thesunRider/hololit/docs/back_layer.PNG

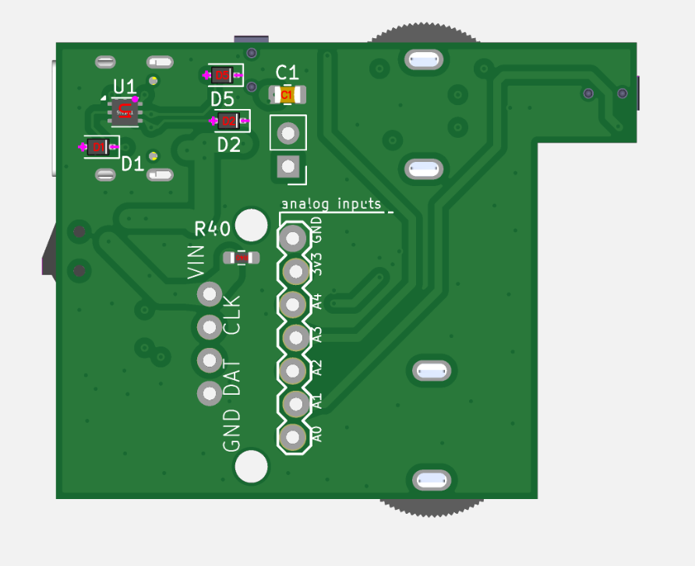
docs/back_layer.PNG
