thesunRider/hololit/docs/capture-2025-04-30T06_42_58.021Z.png

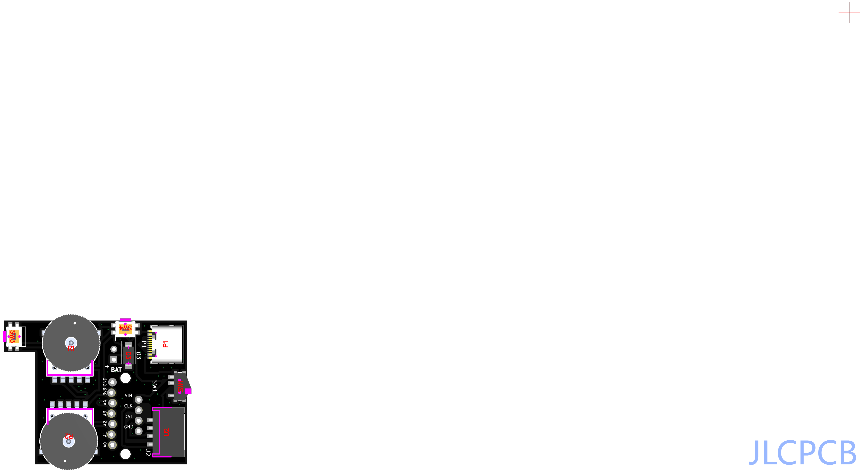
docs/capture-2025-04-30T06_42_58.021Z.png
