thesunRider/hololit/docs/capture-2025-04-30T06_43_24.876Z.png

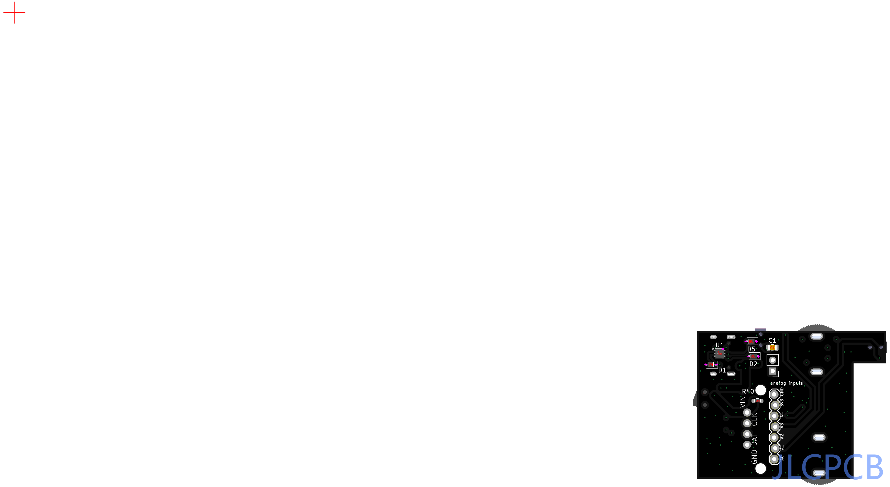
docs/capture-2025-04-30T06_43_24.876Z.png
