thesunRider/hololit/docs/front_layer.PNG

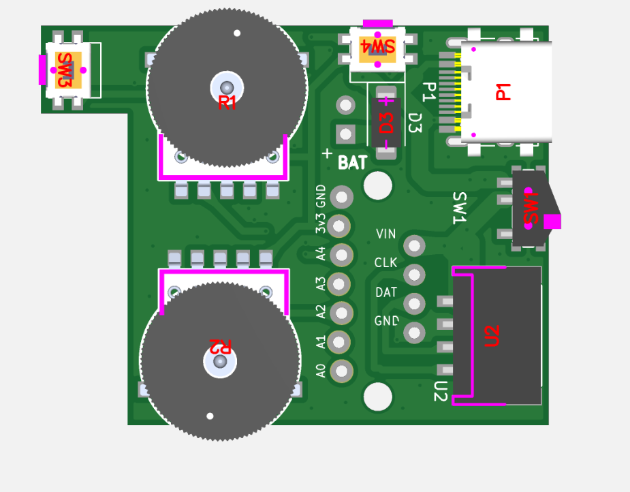
docs/front_layer.PNG
