thesunRider/hololit/docs/sv1.PNG

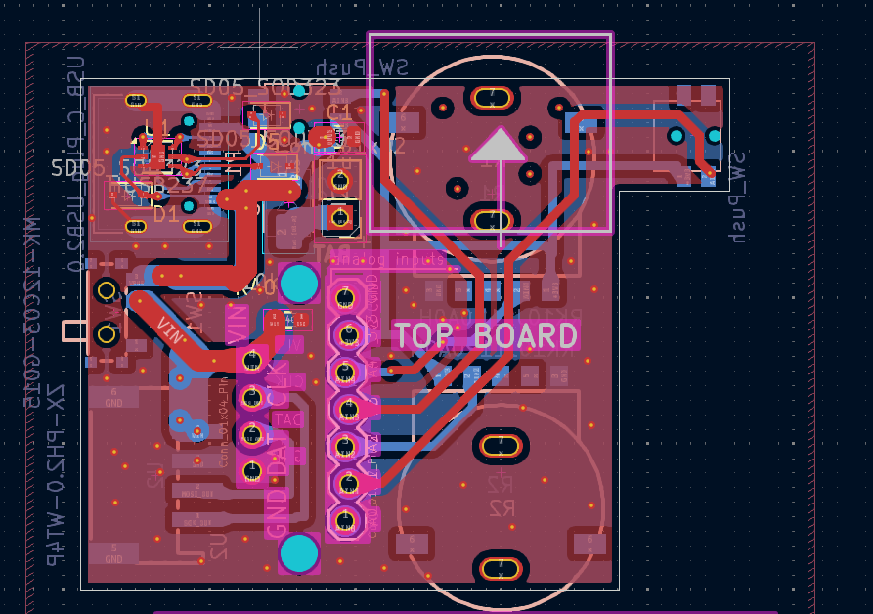
docs/sv1.PNG
