thesunRider/hololit/docs/sv2.PNG

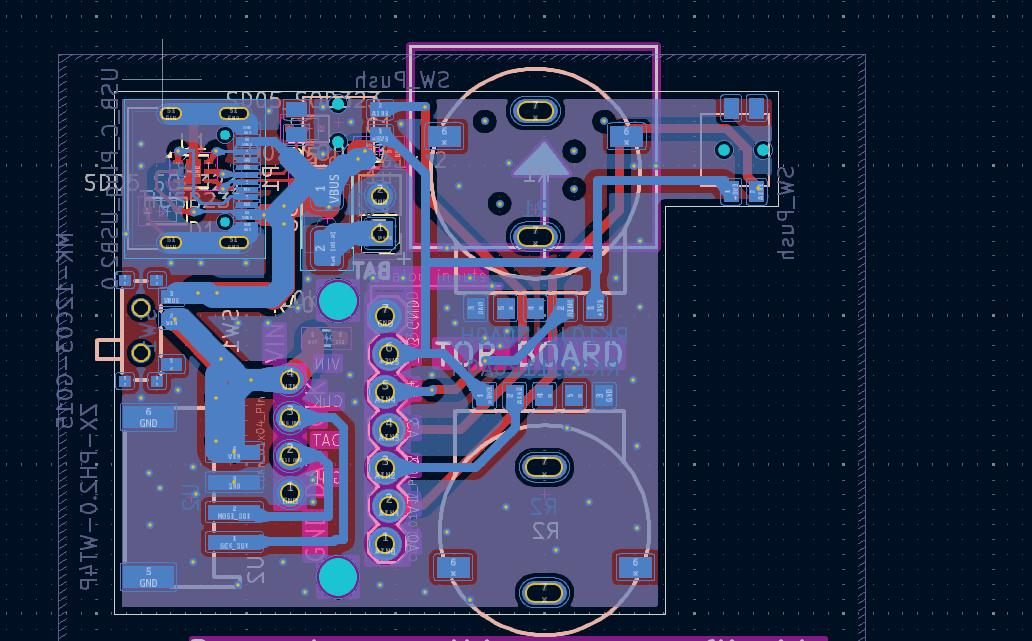
docs/sv2.PNG
