thesunRider/hololit/images/rnd2_bck.PNG

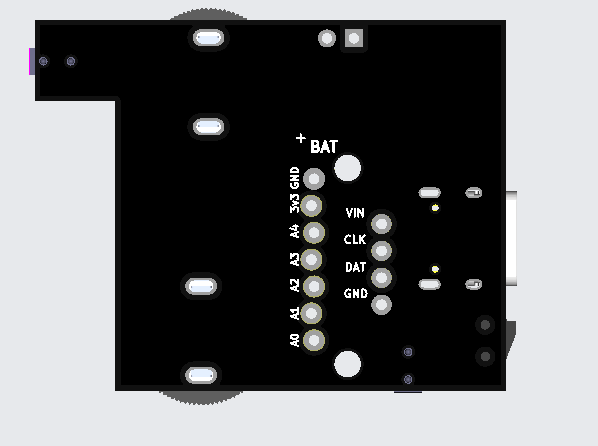
images/rnd2_bck.PNG
