thesunRider/hololit/images/rnd2_front.PNG

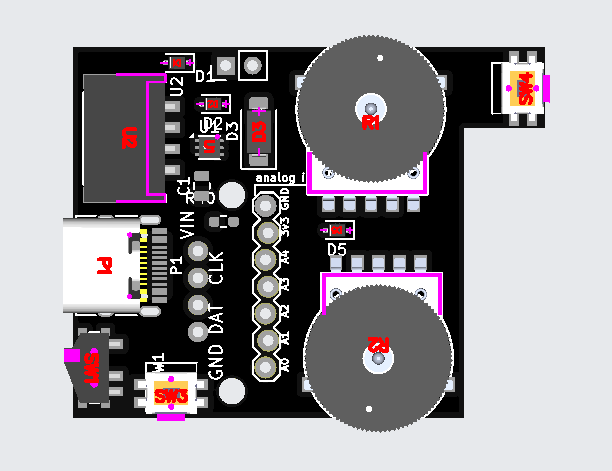
images/rnd2_front.PNG
