thesunRider/hololit/kicad/main/main.kicad_pcb

## KiCad design kicad/main/main.kicad_pcb (2025-07-11)

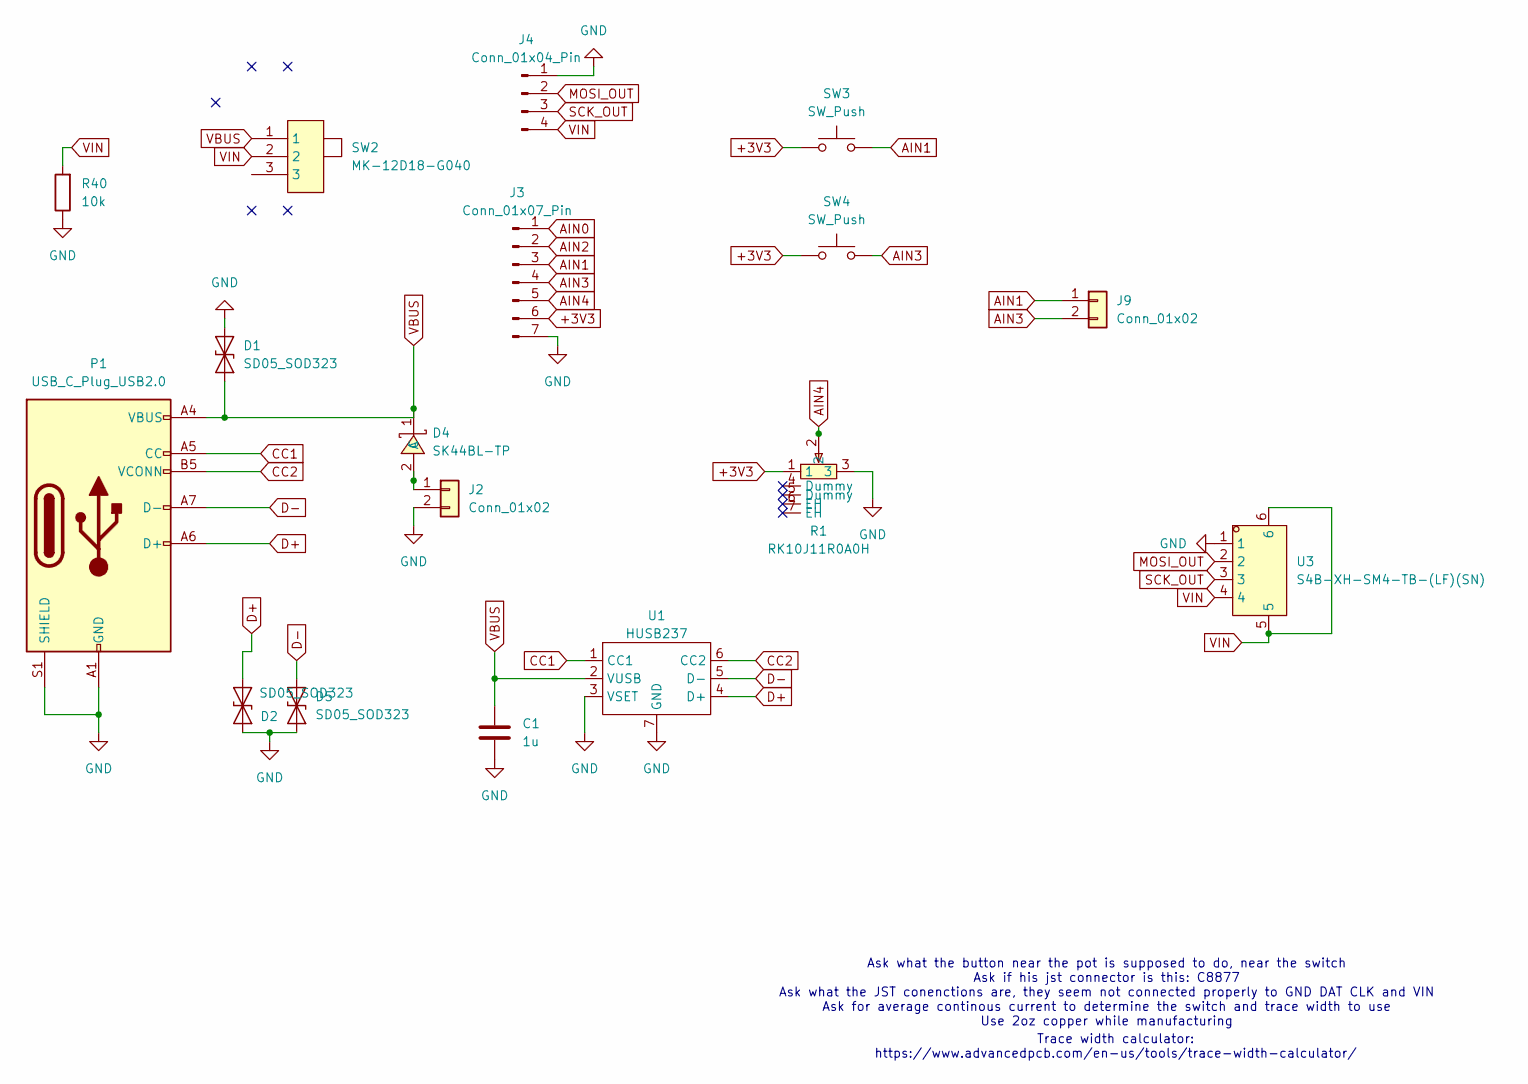
[picture p14: schematic main.kicad_sch]

Parts:
C1: 1u; C_0805_2012Metric
D1, D2, D5: SD05_SOD323; D_SOD-323
D4: SK44BL-TP; SMB_L4.6-W3.6-LS5.3-RD; LCSC Part C151740
J2: Conn_01x02; PinHeader_1x02_P2.54mm_Vertical
J3: Conn_01x07_Pin
J4: Conn_01x04_Pin
J9: Conn_01x02
P1: USB_C_Plug_USB2.0; USB_C_Receptacle_HRO_TYPE-C-31-M-12; Mfr Part TYPE-C-31-M-14; LCSC Part C223907
R1: RK10J11R0A0H; RES-SMD_RK10J11R0A0H; LCSC Part C470766
R40: 10k; R_0603_1608Metric_Pad0.98x0.95mm_HandSolder
SW2: MK-12D18-G040; SW-TH_MK-12D18-G040; LCSC Part C963202
SW3, SW4: SW_Push; K2-1114SA-A4SW-06; Mfr Part K2-1114SA-A4SW-06; LCSC Part C136662
U1: HUSB237; DFN-6-1EP_2x2mm_P0.65mm_EP1.01x1.7mm; LCSC Part C22373734
U3: S4B-XH-SM4-TB-(LF)(SN); CONN-SMD_S4B-XH-SM4-TB-LF-SN; LCSC Part C161861

Connections:
+3V3: J3.6, R1.1, SW3.1, SW4.1
AIN0: J3.1
AIN1: J3.3, J9.1, SW3.2
AIN2: J3.2
AIN3: J3.4, J9.2, SW4.2
AIN4: J3.5, R1.2
CC1: P1.A5 (CC), U1.1 (CC1)
CC2: P1.B5 (VCONN), U1.6 (CC2)
D+: D2.1 (A1), P1.A6 (D+), U1.4 (D+)
D-: D5.1 (A1), P1.A7 (D-), U1.5 (D-)
GND: C1.2, D1.2 (A2), D2.2 (A2), D5.2 (A2), J2.2, J3.7, J4.1, P1.A1 (GND), P1.A12 (GND), P1.B1 (GND), P1.B12 (GND), P1.S1 (SHIELD), R1.3, R40.1, U1.3 (VSET), U1.7 (GND), U3.1
MOSI_OUT: J4.2, U3.2
unnamed: D4.2 (A), J2.1
SCK_OUT: J4.3, U3.3
VBUS: C1.1, D1.1 (A1), D4.1 (C), P1.A4 (VBUS), P1.A9 (VBUS), P1.B4 (VBUS), P1.B9 (VBUS), SW2.1, U1.2 (VUSB)
VIN: J4.4, R40.2, SW2.2, U3.4, U3.5, U3.6

Notes on the sheet:
Trace width calculator: https://www.advancedpcb.com/en-us/tools/trace-width-calculator/
Ask what the button near the pot is supposed to do, near the switch Ask if his jst connector is this: C8877 Ask what the JST conenctions are, they seem not connected properly to GND DAT CLK and VIN Ask for average continous current to determine the switch and trace width to use Use 2oz copper while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

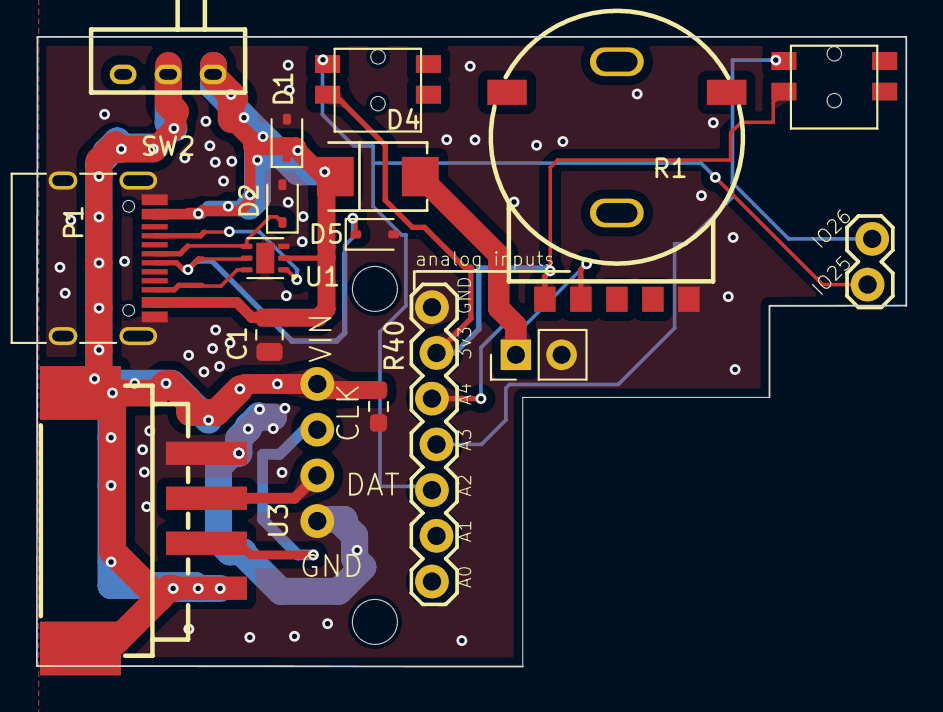
[picture p15: board main.kicad_pcb from above]

Board: 2 copper layers, 48.3 x 35.0 mm, 19 parts (0 on the bottom side), 14 nets.

Other parts of the board:
@HOLE0, @HOLE1: (no value)
