thesunRider/hololit/kicad/main/main2.kicad_pcb

## KiCad design kicad/main/main2.kicad_pcb (2025-05-16)

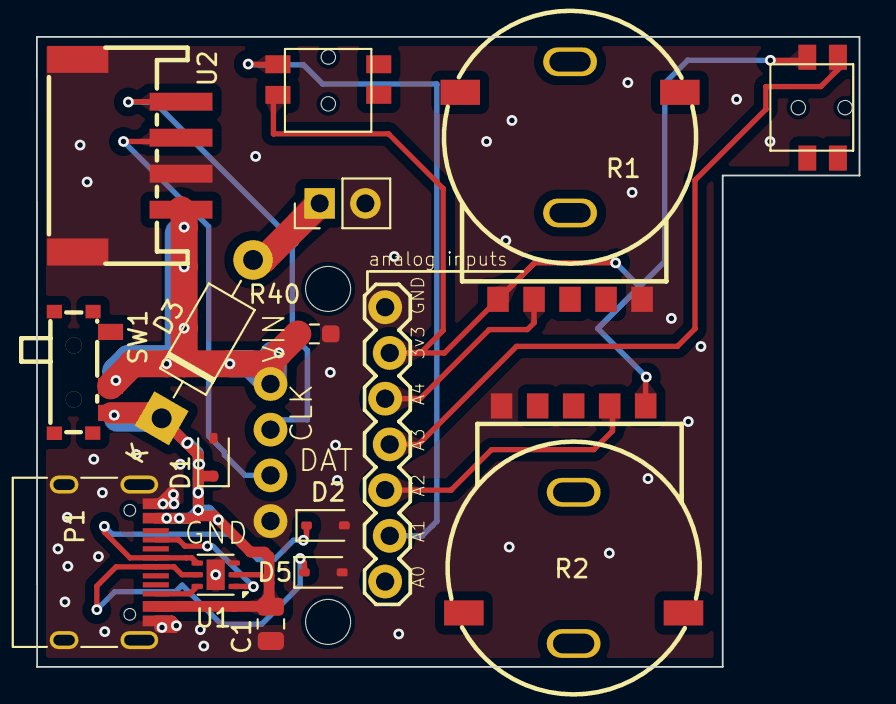
[picture p16: board main2.kicad_pcb from above]

Board: 2 copper layers, 45.7 x 35.0 mm, 19 parts (0 on the bottom side), 15 nets.

Parts:
@HOLE0, @HOLE1: (no value)
C1: 1u; C_0805_2012Metric
D1, D2, D5: SD05_SOD323; D_SOD-323
D3: 1N4007; D_DO-41_SOD81_P10.16mm_Horizontal
J2: Conn_01x02; PinHeader_1x02_P2.54mm_Vertical
J3: Conn_01x07_Pin; 1X07_LOCK_513
J4: Conn_01x04_Pin; 1X04_NO_SILK_513
P1: USB_C_Plug_USB2.0; USB_C_Receptacle_HRO_TYPE-C-31-M-12
R1, R2: RK10J11R0A0H; RES-SMD_RK10J11R0A0H
R40: 10k; R_0603_1608Metric_Pad0.98x0.95mm_HandSolder
SW1: MK-12C03-G015; SW-SMD_MK-12C03-G015
SW3, SW4: SW_Push; K2-1114SA-A4SW-06
U1: HUSB237; DFN-6-1EP_2x2mm_P0.65mm_EP1.01x1.7mm
U2: ZX-PH2.0-WT4P; CONN-SMD_4P-P2.00_C2001RS10411M0101RC

Connections:
+3V3: J3.6, R1.1, R2.1, SW3.1, SW4.1
AIN1: J3.2, SW3.2
AIN2: J3.3, R2.2
AIN3: J3.4, SW4.2
AIN4: J3.5, R1.2
CC1: P1.A5 (CC), U1.1 (CC1)
CC2: P1.B5 (VCONN), U1.6 (CC2)
D+: D2.1 (A1), P1.A6 (D+), U1.4 (D+)
D-: D5.1 (A1), P1.A7 (D-), U1.5 (D-)
GND: C1.2, D1.2 (A2), D2.2 (A2), D5.2 (A2), J2.2, J3.7, J4.1, P1.A1 (GND), P1.A12 (GND), P1.B1 (GND), P1.B12 (GND), P1.S1 (SHIELD), R1.3, R2.3, R40.1, U1.3 (VSET), U1.7 (GND), U2.3, U2.5, U2.6
MOSI_OUT: J4.2, U2.2
unnamed: D3.2 (A), J2.1
SCK_OUT: J4.3, U2.1
VBUS: C1.1, D1.1 (A1), D3.1 (K), P1.A4 (VBUS), P1.A9 (VBUS), P1.B4 (VBUS), P1.B9 (VBUS), SW1.3, U1.2 (VUSB)
VIN: J4.4, R40.2, SW1.2, U2.4
