thesunRider/hololit/drawings/Drawings/Sensor Board/neoimage_sensors small.brd

## EAGLE design drawings/Drawings/Sensor Board/neoimage_sensors small.brd (2025-04-27)

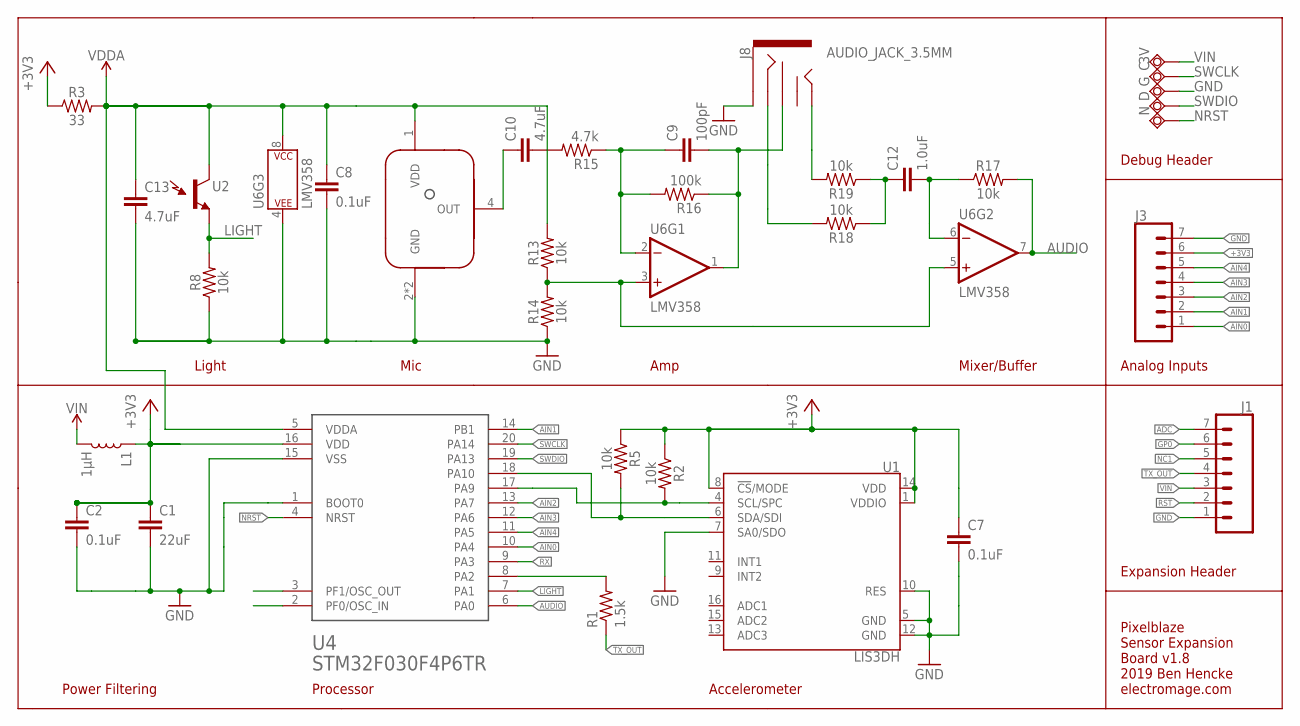
[picture p17: schematic neoimage_sensors small.sch]

Parts:
3V: TPSQTP18SQ; TP18SQ
C: TPSQTP18SQ; TP18SQ
C1: 22uF; 0805
C2, C7, C8: 0.1uF; 0603
C9: 100pF; 0603
C10, C13: 4.7uF; 0603
C12: 1.0uF; 0603
D: TPSQTP18SQ; TP18SQ
G: TPSQTP18SQ; TP18SQ
J1, J3: CONN_07LOCK; 1X07_LOCK
J8: AUDIO_JACK_3.5MM; AUDIO-JACK-KIT
L1: 1µH; 0805
N: TPSQTP18SQ; TP18SQ
R1: 1.5k; 0603
R2, R5, R8, R13, R14, R17, R18, R19: 10k; 0603
R3: 33; 0603
R15: 4.7k; 0603
R16: 100k; 0603
U1: LIS3DH; LGA-16-3X3
U2: LIGHT_SENSORALS; ALS-PT19
U4: STM32F030F4P6TR; TSSOP-20
U6: LMV358; SO08
U$3: MICROPHONE-MEMS; MICROPHONE-MEMS-3X3.75

Connections:
+3V3: C1.1, C2.1, C7.1, J3.6, L1.1, R2.1, R3.1, R5.1, U1.1 (VDDIO), U1.8 (!CS!/MODE), U1.14 (VDD), U4.16 (VDD)
ADC: J1.7
AIN0: J3.1, U4.10 (PA4)
AIN1: J3.2, U4.14 (PB1)
AIN2: J3.3, U4.13 (PA7)
AIN3: J3.4, U4.12 (PA6)
AIN4: J3.5, U4.11 (PA5)
AUDIO: R17.2, U4.6 (PA0), U6.7 (OUT)
GND: C1.2, C2.2, C7.2, C8.2, C13.2, G.TP, J1.1, J3.7, J8.SLEEVE, R8.1, R14.1, U1.5 (GND), U1.7 (SA0/SDO), U1.10 (RES), U1.12 (GND), U4.1 (BOOT0), U4.15 (VSS), U6.4 (P$V-), U$3.2 (GND), U$3.3 (GND)
GP0: J1.6
LIGHT: R8.2, U2.E (E1), U4.7 (PA1)
MICOUT: C9.2, J8.RSH, R16.1, U6.1 (OUT)
unnamed: C10.1, U$3.4 (OUT)
unnamed: C9.1, R15.1, R16.2, U6.2 (-IN)
unnamed: C10.2, R15.2
unnamed: R13.1, R14.2, U6.3 (+IN), U6.5 (+IN)
unnamed: C12.1, R18.1, R19.1
unnamed: C12.2, R17.1, U6.6 (-IN)
unnamed: J8.TIP, R19.2
unnamed: J8.RING, R18.2
NC1: J1.5
NRST: N.TP, U4.4 (NRST)
RST: J1.2
RX: U4.9 (PA3)
SCL: R5.2, U1.6 (SDA/SDI), U4.18 (PA10)
SDA: R2.2, U1.4 (SCL/SPC), U4.17 (PA9)
SWCLK: C.TP, U4.20 (PA14)
SWDIO: D.TP, U4.19 (PA13)
TX: R1.2, U4.8 (PA2)
TX_OUT: J1.4, R1.1
VDDA: C8.1, C13.1, R3.2, R13.2, U2.C (C1), U4.5 (VDDA), U6.8 (P$V+), U$3.1 (VDD)
VIN: 3V.TP, J1.3, L1.2

Notes on the sheet:
Expansion Header
Analog Inputs
Debug Header
Mic
Accelerometer
Processor
Light
Amp
Mixer/Buffer
Power Filtering
Pixelblaze Sensor Expansion Board v1.8 2019 Ben Hencke electromage.com

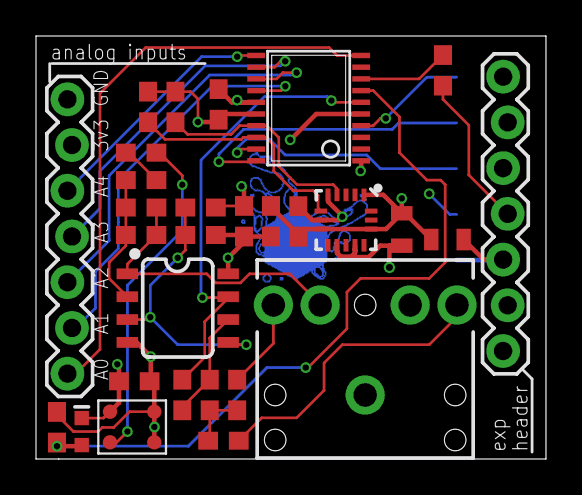
[picture p18: board neoimage_sensors small.brd from above]

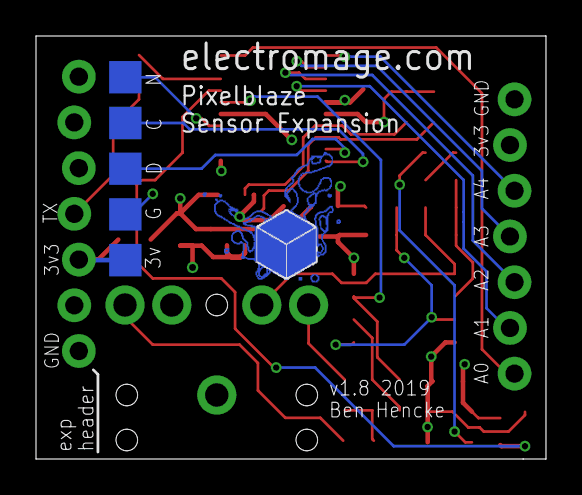
[picture p19: board neoimage_sensors small.brd from below]

Board: 4 copper layers, 28.3 x 23.5 mm, 35 parts (6 on the bottom side), 27 nets.

Other parts of the board:
U$4: ELECTRO_MAGE_PCB4_PIXEL_2#PNG
