thesunRider/hololit/drawings/Drawings/Pixelblaze/PB32_3.x.brd

## EAGLE design drawings/Drawings/Pixelblaze/PB32_3.x.brd (2025-04-27)

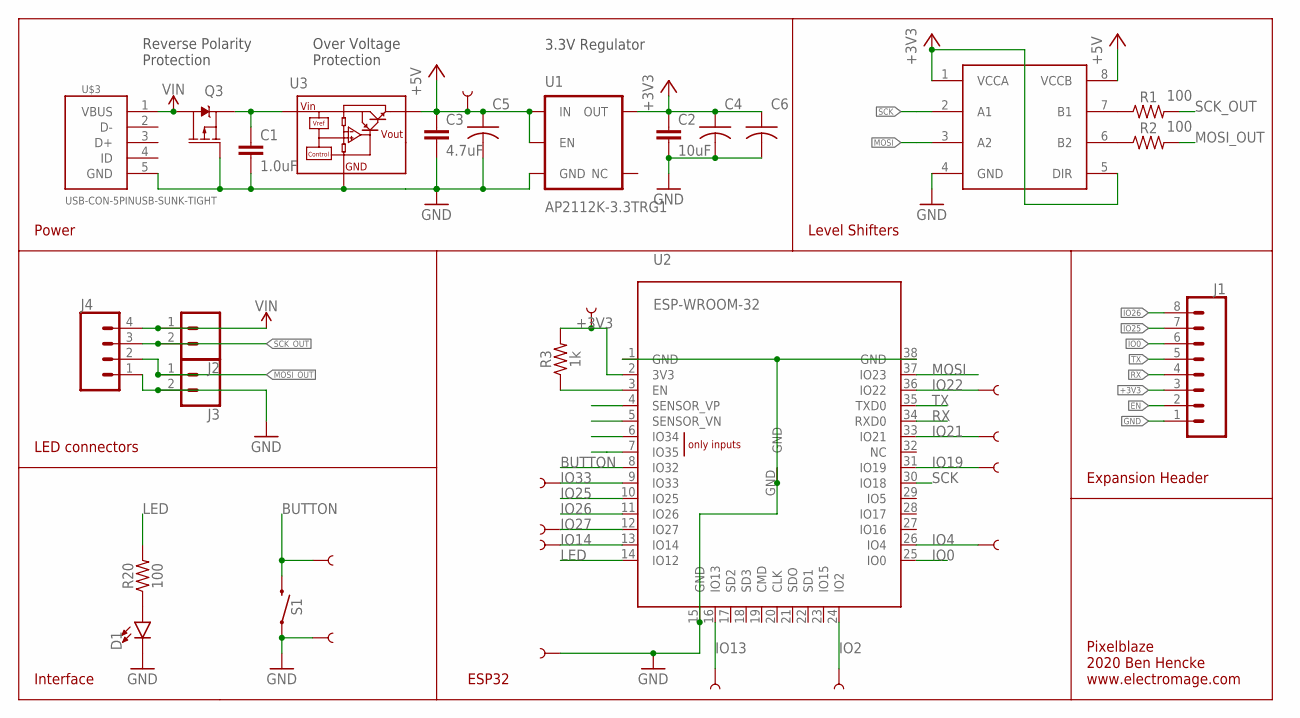
[picture p20: schematic PB32_3.x.sch]

Parts:
C1: 1.0uF; 0805-CAP
C2: 10uF; 0805
C3: 4.7uF; 0603
C4, C5, C6: 0.1uF; C0402K
D1: LED0603; LED-0603
GP1, GP3, GP6, GP8, GP9: SMTPAD; PAD
IO2, IO4, IO13, IO14, IO19, IO21, IO22, IO27, IO33: SMTPAD; PAD
J1: CONN_08LOCK; 1X08_LOCK
J2, J3: CONN_025MM; SCREWTERMINAL-5MM-2
J4: CONN_041X04_NO_SILK; 1X04_NO_SILK
Q3: 2.5A/30V/105mΩ; SOT23-3
R1, R2, R20: 100; 0603
R3: 1k; 0603
S1: MOMENTARY-SWITCH-SPST-SMD-5.2MM; TACTILE_SWITCH_SMD_5.2MM
U1: AP2112K-3.3TRG1; SOT23-5
U2: ESP-WROOM-32
U3: NX1117C15Z; SOT223
U$1: SN74LVC2T45DCUR; SOP50P310X90-8N
U$3: USB-CON-5PINUSB-SUNK-TIGHT; USB-SUNK-TIGHT

Connections:
+3V3: C2.1, C4.1, C6.1, GP1.P$1, J1.3, R3.2, U1.5 (OUT), U2.2 (3V3), U$1.1 (VCCA), U$1.5 (DIR)
+5V: C3.1, C5.1, GP6.P$1, U1.1 (IN), U1.3 (EN), U3.2 (VOUT), U3.4 (VOUT), U$1.8 (VCCB)
BUTTON: GP8.P$1, S1.3 (2), U2.8 (IO32)
EN: J1.2, R3.1, U2.3 (EN)
GND: C1.2, C2.2, C3.2, C4.2, C5.2, C6.2, D1.C, GP3.P$1, GP9.P$1, J1.1, J3.2, J4.1, Q3.1 (G), S1.1, U1.2 (GND), U2.1 (GND), U2.15 (GND), U2.38 (GND), U2.GND, U3.1 (GND), U$1.4 (GND), U$3.5 (GND)
IO0: J1.6, U2.25 (IO0)
IO2: IO2.P$1, U2.24 (IO2)
IO4: IO4.P$1, U2.26 (IO4)
IO13: IO13.P$1, U2.16 (IO13)
IO14: IO14.P$1, U2.13 (IO14)
IO19: IO19.P$1, U2.31 (IO19)
IO21: IO21.P$1, U2.33 (IO21)
IO22: IO22.P$1, U2.36 (IO22)
IO25: J1.7, U2.10 (IO25)
IO26: J1.8, U2.11 (IO26)
IO27: IO27.P$1, U2.12 (IO27)
IO33: IO33.P$1, U2.9 (IO33)
LED: R20.2, U2.14 (IO12)
MOSI: U2.37 (IO23), U$1.3 (A2)
MOSI_OUT: J3.1, J4.2, R2.2
unnamed: C1.1, Q3.2 (S), U3.3 (VIN)
unnamed: R1.1, U$1.7 (B1)
unnamed: R2.1, U$1.6 (B2)
unnamed: D1.A, R20.1
RX: J1.4, U2.34 (RXD0)
SCK: U2.30 (IO18), U$1.2 (A1)
SCK_OUT: J2.2, J4.3, R1.2
TX: J1.5, U2.35 (TXD0)
VIN: J2.1, J4.4, Q3.3 (D), U$3.1 (VBUS)

Notes on the sheet:
Power
LED connectors
ESP32
Expansion Header
Level Shifters
Pixelblaze 2020 Ben Hencke www.electromage.com
Interface
Reverse Polarity Protection
Over Voltage Protection
3.3V Regulator

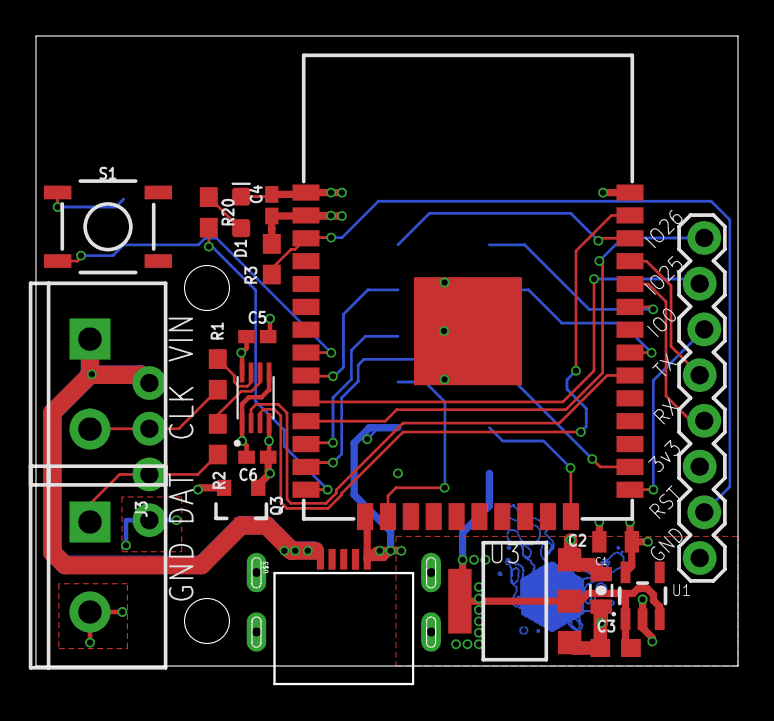
[picture p21: board PB32_3.x.brd from above]

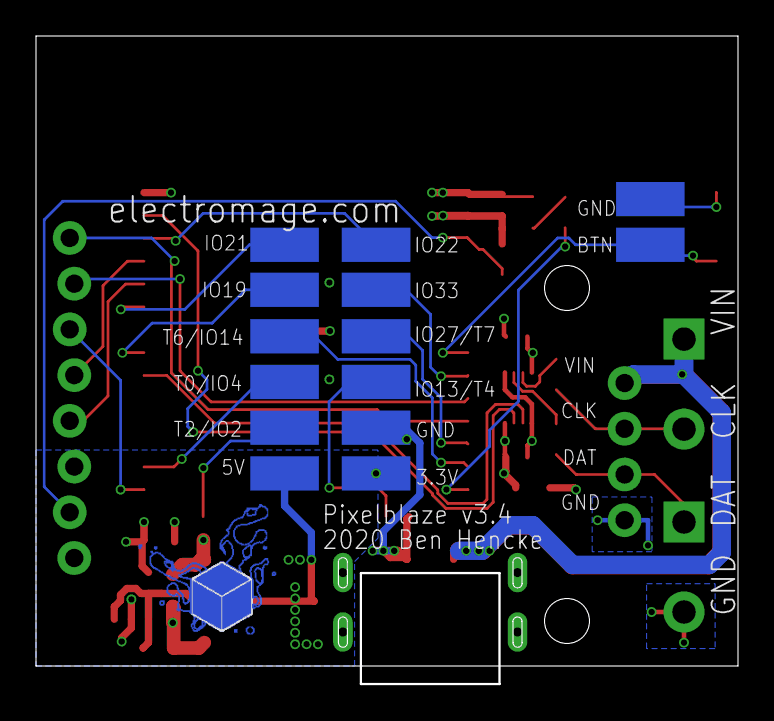
[picture p22: board PB32_3.x.brd from below]

Board: 4 copper layers, 39.0 x 36.0 mm, 37 parts (15 on the bottom side), 29 nets.

Other parts of the board:
U$2: ELECTRO_MAGE_PCB4_PIXEL_2#PNG
