thesunRider/hololit/(commit log)

2025-04-27 Added components ,2 pots 2 switches and usb
    [PB32_3.x.brd, PB32_3.x.sch, main.kicad_pcb, main.kicad_sch, neoimage_sensors small.brd, neoimage_sensors small.sch]
2025-04-27 Switches added
    [main.kicad_pcb, main.kicad_sch]
2025-04-27 Added extra switched
    [main.kicad_pcb, main.kicad_sch]
2025-04-27 Finished design
    [main.kicad_pcb, main.kicad_sch]
2025-04-27 Finished design added more vias
    [main.kicad_pcb]
2025-04-27 Rotated switch
    [main.kicad_pcb]
2025-04-27 Increased trace widths
    [main.kicad_pcb]
2025-04-28 Added more traces
    [main.kicad_pcb]
2025-05-05 New board arrangement
    [main.kicad_pcb]
2025-05-16 Rewired PCB
    [main.kicad_pcb, main.kicad_sch]
2025-05-16 Final push
    [bom-JLCPCB Assembly Order.xls, bom_updated.xlsx, main.kicad_pcb]
2025-05-19 Final push with moved components
    [bom_updated.xlsx, main.kicad_pcb, main.kicad_sch, main2.kicad_pcb]
2025-07-11 Revamped PCB
    [main.kicad_pcb, main.kicad_sch]
